alvestav/alvestav-lee-thesis-project-2025/pcb-front-view.png

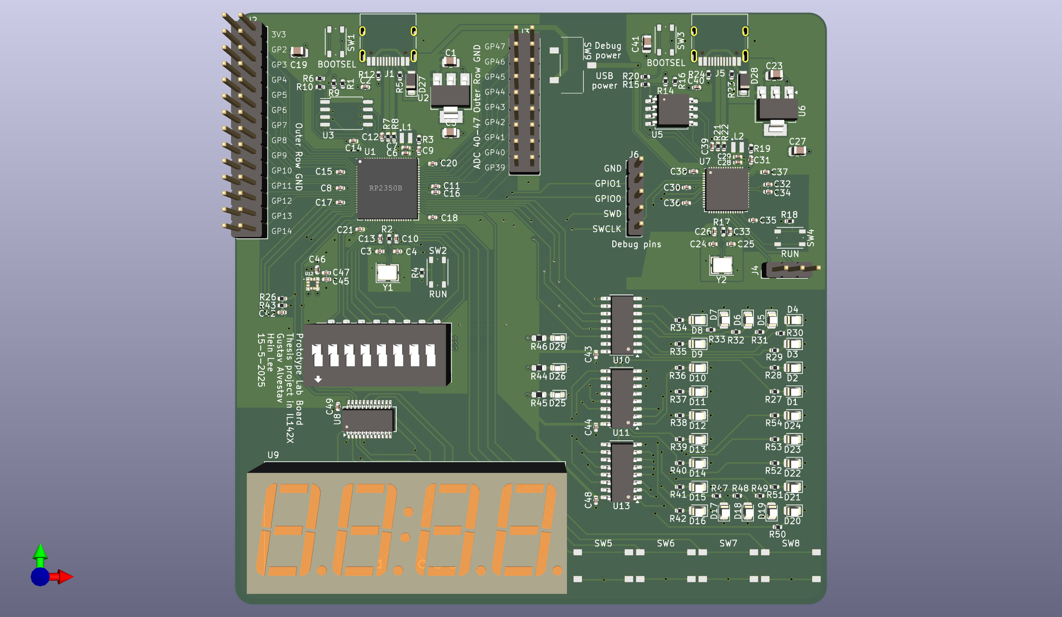
pcb-front-view.png
