alvestav/alvestav-lee-thesis-project-2025/README.md

# alvestav-lee-thesis-project-2025
 This is the GitHub repository for the bachelor thesis project in KTH computer and electronics engineering
