alvestav/alvestav-lee-thesis-project-2025/RP-006442-DD-2-RP2350B Minimal Board Kicad archive/MMA8451QR1.step

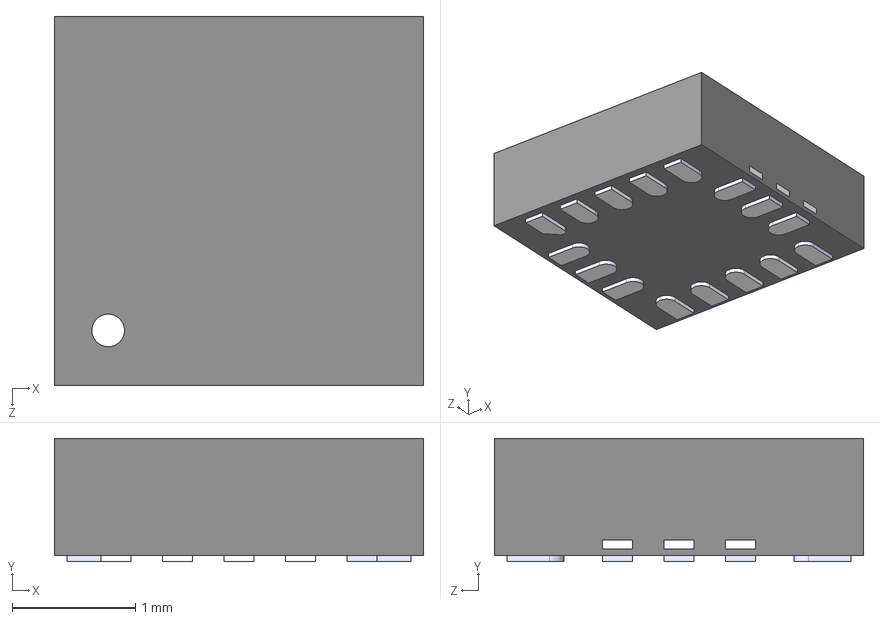
[picture p2: CAD file, 2025-05-16, an earlier design]
RP-006442-DD-2-RP2350B Minimal Board Kicad archive/MMA8451QR1.step
3.00 x 1.00 x 3.00 mm
