alvestav/alvestav-lee-thesis-project-2025/RP-006442-DD-2-RP2350B Minimal Board Kicad archive/W25Q128JVSIQ.step

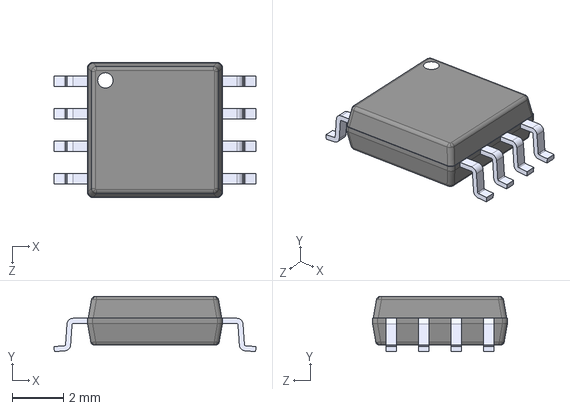
[picture p3: CAD file, 2025-05-16, an earlier design]
RP-006442-DD-2-RP2350B Minimal Board Kicad archive/W25Q128JVSIQ.step
7.90 x 2.16 x 5.28 mm
