alvestav/alvestav-lee-thesis-project-2025/RP-006442-DD-2-RP2350B Minimal Board Kicad archive/LIS2DW12TR.step

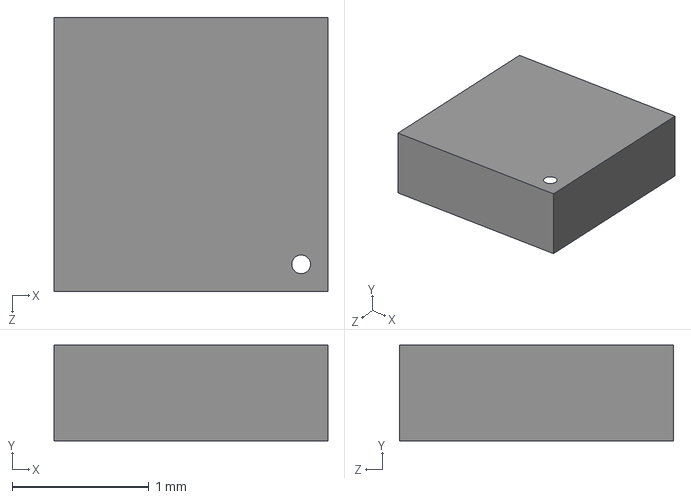
[picture p4: CAD file, 2025-05-13, an earlier design]
RP-006442-DD-2-RP2350B Minimal Board Kicad archive/LIS2DW12TR.step
2.00 x 0.7 x 2.00 mm
