alvestav/alvestav-lee-thesis-project-2025/RP-006442-DD-2-RP2350B Minimal Board Kicad archive/RP2350_QFN60.step

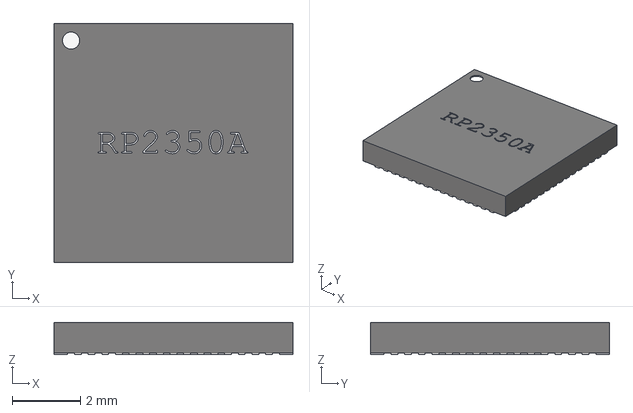
[picture p5: CAD file, 2025-04-09, an earlier design]
RP-006442-DD-2-RP2350B Minimal Board Kicad archive/RP2350_QFN60.step
7.00 x 7.00 x 0.95 mm
