alvestav/alvestav-lee-thesis-project-2025/RP-006442-DD-2-RP2350B Minimal Board Kicad archive/RP2350_QFN80.step

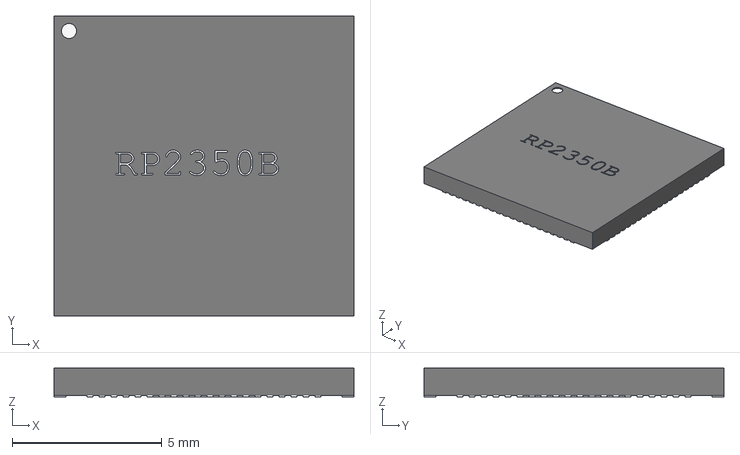
[picture p6: CAD file, 2025-03-20, an earlier design]
RP-006442-DD-2-RP2350B Minimal Board Kicad archive/RP2350_QFN80.step
10.0 x 10.0 x 0.95 mm
