alvestav/alvestav-lee-thesis-project-2025/RP-006442-DD-2-RP2350B Minimal Board Kicad archive/RP2350_80QFN_minimal.kicad_pcb

## KiCad design RP-006442-DD-2-RP2350B Minimal Board Kicad archive/RP2350_80QFN_minimal.kicad_pcb (2025-05-22, an earlier design)

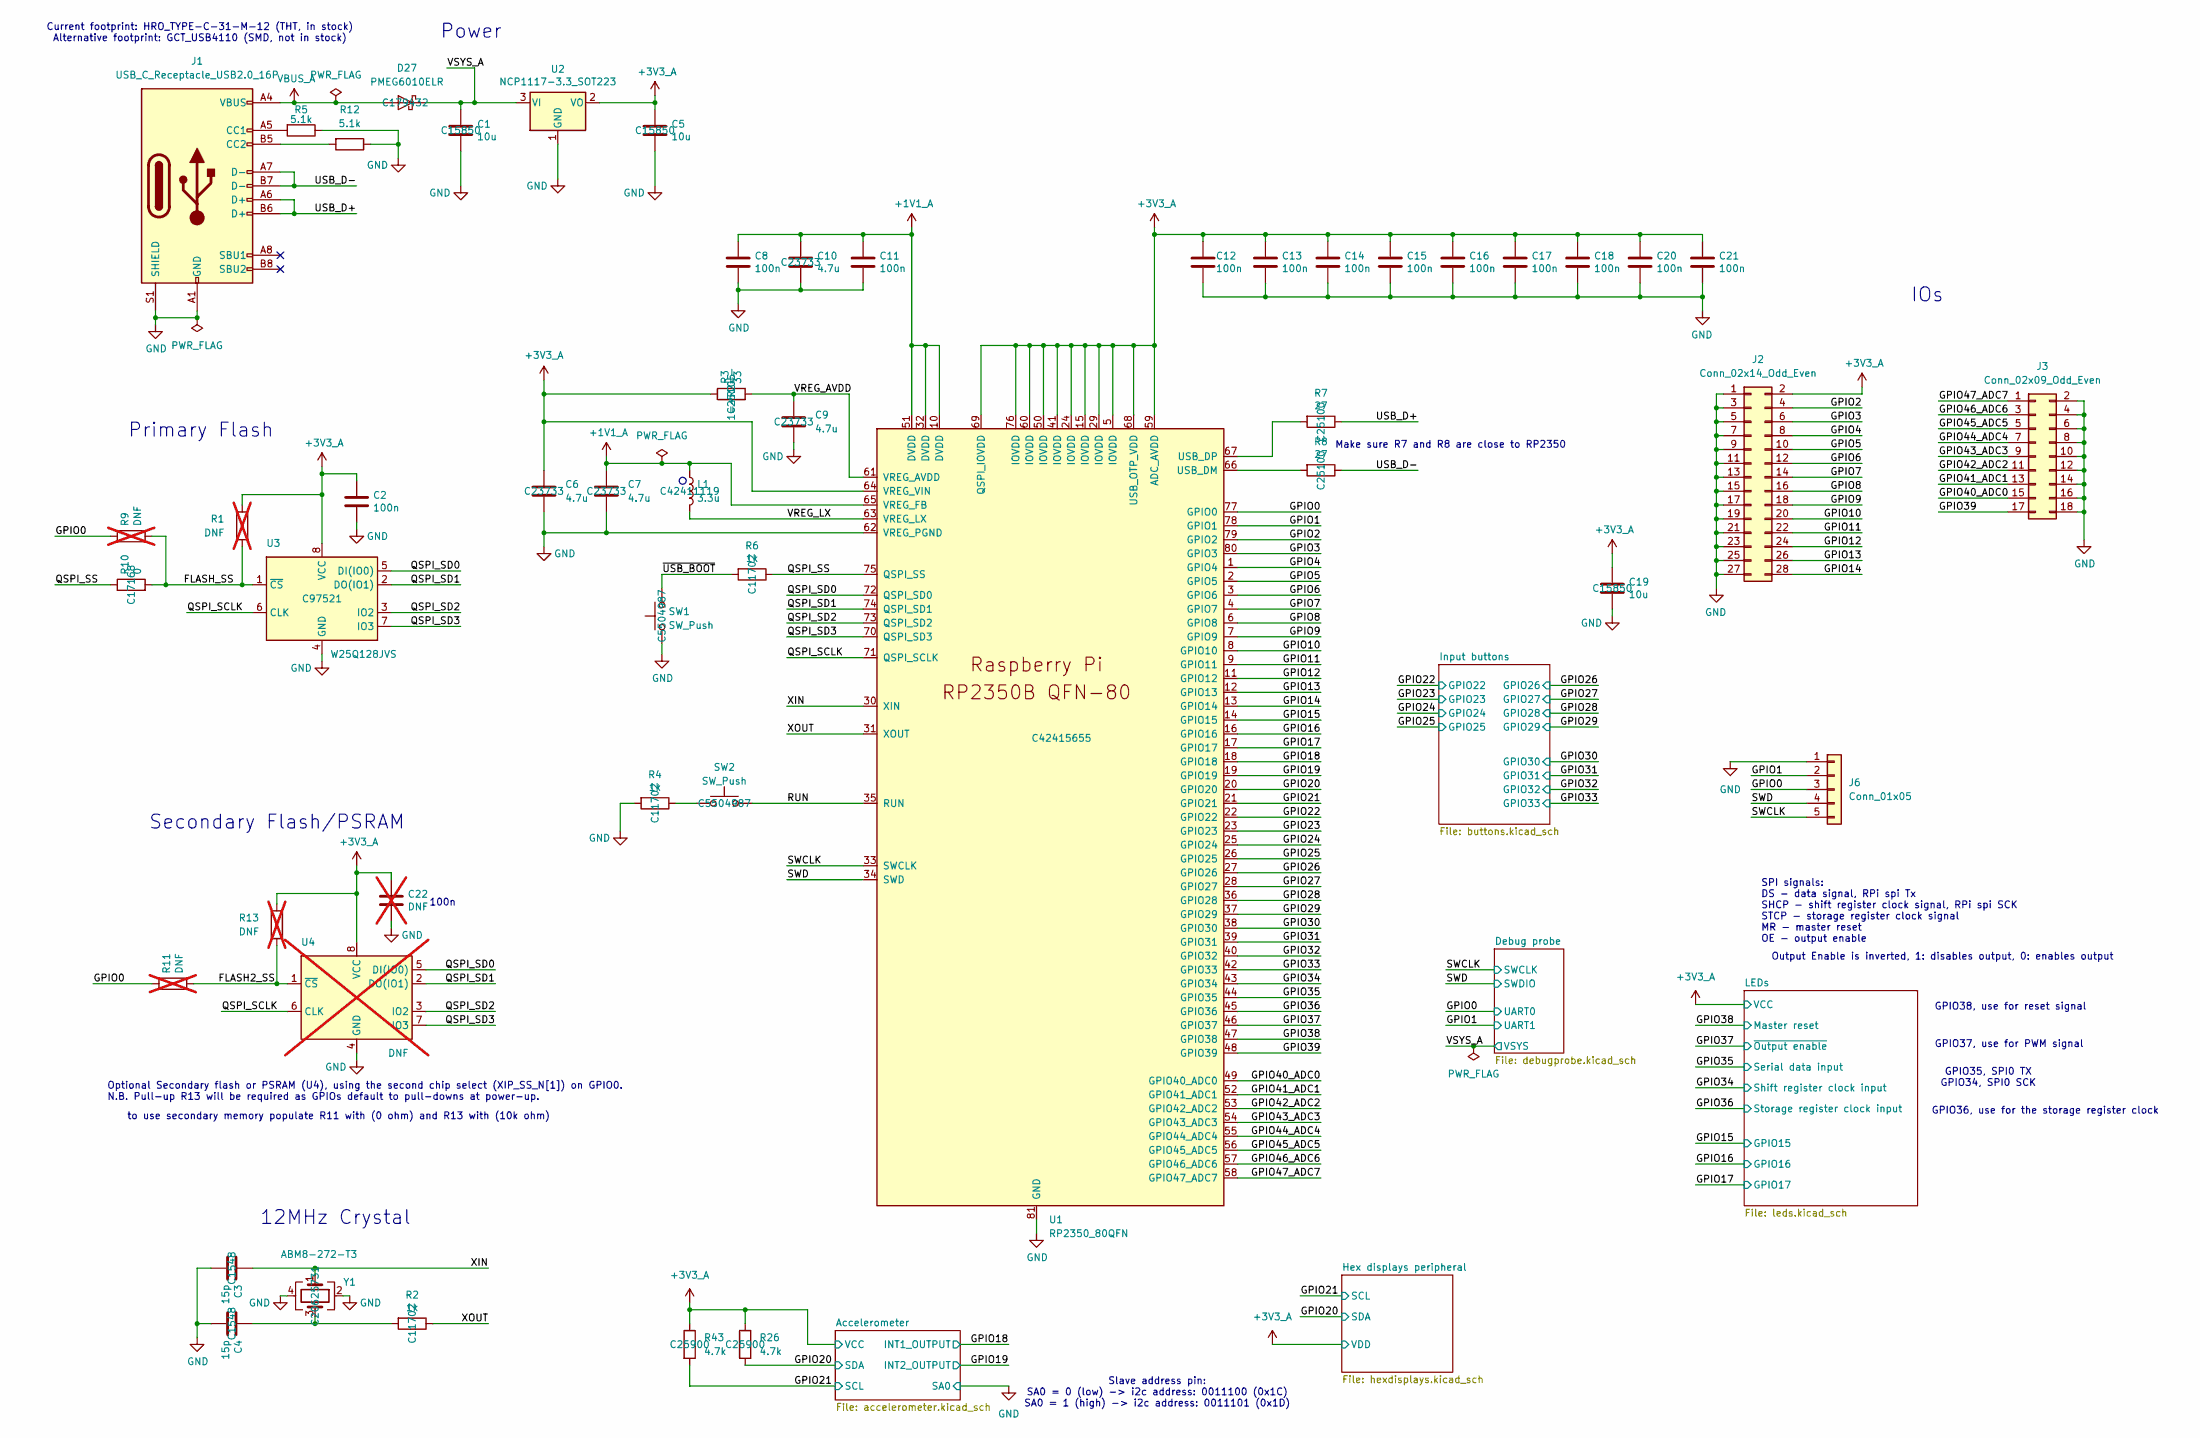
[picture p7: schematic RP2350_80QFN_minimal.kicad_sch, Lab Platform Prototype Thesis Project]

Parts:
C1, C5, C19: 10u; C_0805_2012Metric; LCSC C15850
C2, C8, C11, C12, C13, C14, C15, C16, C17, C18, C20, C21: 100n; C_0402_1005Metric; LCSC C1525
C3, C4: 15p; C_0402_1005Metric; LCSC C1548
C6, C7: 4.7u; C_0402_1005Metric_small_pads; LCSC C23733
C9, C10: 4.7u; C_0402_1005Metric; LCSC C23733
C22: DNF; C_0402_1005Metric; not fitted
D27: PMEG6010ELR; Nexperia_CFP3_SOD-123W; LCSC C179432
J1: USB_C_Receptacle_USB2.0_16P; USB_C_Receptacle_HRO_TYPE-C-31-M-12; LCSC C165948
J2: Conn_02x14_Odd_Even; PinHeader_2x14_P2.54mm_Vertical
J3: Conn_02x09_Odd_Even; PinHeader_2x09_P2.54mm_Vertical
J6: Conn_01x05; PinHeader_1x05_P2.54mm_Vertical
L1: 3.3u; L_pol_2016; LCSC C42411119
R1, R9, R11, R13: DNF; R_0402_1005Metric; not fitted
R2, R4, R6: 1k; R_0402_1005Metric; LCSC C11702
R3: 33; R_0402_1005Metric; LCSC C25105
R5, R12: 5.1k; R_0402_1005Metric; LCSC C25905
R7, R8: 27; R_0402_1005Metric; LCSC C25100
R10: 0; R_0402_1005Metric; LCSC C17168
R26, R43: 4.7k; R_0402_1005Metric; LCSC C25900
SW1, SW2: SW_Push; SW_Push_1P1T_NO_Vertical_Wuerth_434133025816; LCSC C5504987
U1: RP2350_80QFN; RP2350-QFN-80-1EP_10x10_P0.4mm_EP3.4x3.4mm_ThermalVias; LCSC C42415655
U2: NCP1117-3.3_SOT223; SOT-223-3_TabPin2; LCSC C26537
U3: W25Q128JVS; SOIC127P790X216-8N; LCSC C97521
U4: DNF; SOIC127P790X216-8N; not fitted
Y1: ABM8-272-T3; Crystal_SMD_3225-4Pin_3.2x2.5mm; LCSC C20625731

Connections:
+1V1_A: C7.1, C8.1, C10.1, C11.1, L1.1, U1.10 (DVDD), U1.32 (DVDD), U1.51 (DVDD), U1.65 (VREG_FB)
+3V3_A: C2.1, C5.1, C6.1, C12.1, C13.1, C14.1, C15.1, C16.1, C17.1, C18.1, C19.1, C20.1, C21.1, C22.1, J2.2, R1.1, R3.1, R13.1, R26.1, R43.1, U1.5 (IOVDD), U1.15 (IOVDD), U1.24 (IOVDD), U1.29 (IOVDD), U1.41 (IOVDD), U1.50 (IOVDD), U1.59 (ADC_AVDD), U1.60 (IOVDD), U1.64 (VREG_VIN), U1.68 (USB_OTP_VDD), U1.69 (QSPI_IOVDD), U1.76 (IOVDD), U2.2 (VO), U3.8 (VCC), U4.8 (VCC); also elsewhere on the board
/FLASH2_SS: R11.2, R13.2, U4.1 (~CS)
/FLASH_SS: R1.2, R9.2, R10.2, U3.1 (~CS)
/GPIO0: J6.3, R9.1, R11.1, U1.77 (GPIO0); also elsewhere on the board
/GPIO1: J6.2, U1.78 (GPIO1); also elsewhere on the board
/GPIO2: J2.4, U1.79 (GPIO2)
/GPIO3: J2.6, U1.80 (GPIO3)
/GPIO4: J2.8, U1.1 (GPIO4)
/GPIO5: J2.10, U1.2 (GPIO5)
/GPIO6: J2.12, U1.3 (GPIO6)
/GPIO7: J2.14, U1.4 (GPIO7)
/GPIO8: J2.16, U1.6 (GPIO8)
/GPIO9: J2.18, U1.7 (GPIO9)
/GPIO10: J2.20, U1.8 (GPIO10)
/GPIO11: J2.22, U1.9 (GPIO11)
/GPIO12: J2.24, U1.11 (GPIO12)
/GPIO13: J2.26, U1.12 (GPIO13)
/GPIO14: J2.28, U1.13 (GPIO14)
/GPIO15: U1.14 (GPIO15); also elsewhere on the board
/GPIO16: U1.16 (GPIO16); also elsewhere on the board
/GPIO17: U1.17 (GPIO17); also elsewhere on the board
/GPIO18: U1.18 (GPIO18); also elsewhere on the board
/GPIO19: U1.19 (GPIO19); also elsewhere on the board
/GPIO20: R26.2, U1.20 (GPIO20); also elsewhere on the board
/GPIO21: R43.2, U1.21 (GPIO21); also elsewhere on the board
/GPIO22: U1.22 (GPIO22); also elsewhere on the board
/GPIO23: U1.23 (GPIO23); also elsewhere on the board
/GPIO24: U1.25 (GPIO24); also elsewhere on the board
/GPIO25: U1.26 (GPIO25); also elsewhere on the board
/GPIO26: U1.27 (GPIO26); also elsewhere on the board
/GPIO27: U1.28 (GPIO27); also elsewhere on the board
/GPIO28: U1.36 (GPIO28); also elsewhere on the board
/GPIO29: U1.37 (GPIO29); also elsewhere on the board
/GPIO30: U1.38 (GPIO30); also elsewhere on the board
/GPIO31: U1.39 (GPIO31); also elsewhere on the board
/GPIO32: U1.40 (GPIO32); also elsewhere on the board
/GPIO33: U1.42 (GPIO33); also elsewhere on the board
/GPIO34: U1.43 (GPIO34); also elsewhere on the board
/GPIO35: U1.44 (GPIO35); also elsewhere on the board
/GPIO36: U1.45 (GPIO36); also elsewhere on the board
/GPIO37: U1.46 (GPIO37); also elsewhere on the board
/GPIO38: U1.47 (GPIO38); also elsewhere on the board
/GPIO39: J3.17, U1.48 (GPIO39)
/GPIO40_ADC0: J3.15, U1.49 (GPIO40_ADC0)
/GPIO41_ADC1: J3.13, U1.52 (GPIO41_ADC1)
/GPIO42_ADC2: J3.11, U1.53 (GPIO42_ADC2)
/GPIO43_ADC3: J3.9, U1.54 (GPIO43_ADC3)
/GPIO44_ADC4: J3.7, U1.55 (GPIO44_ADC4)
/GPIO45_ADC5: J3.5, U1.56 (GPIO45_ADC5)
/GPIO46_ADC6: J3.3, U1.57 (GPIO46_ADC6)
/GPIO47_ADC7: J3.1, U1.58 (GPIO47_ADC7)
/QSPI_SCLK: U1.71 (QSPI_SCLK), U3.6 (CLK), U4.6 (CLK)
/QSPI_SD0: U1.72 (QSPI_SD0), U3.5 (DI(IO0)), U4.5 (DI(IO0))
/QSPI_SD1: U1.74 (QSPI_SD1), U3.2 (DO(IO1)), U4.2 (DO(IO1))
/QSPI_SD2: U1.73 (QSPI_SD2), U3.3 (IO2), U4.3 (IO2)
/QSPI_SD3: U1.70 (QSPI_SD3), U3.7 (IO3), U4.7 (IO3)
/QSPI_SS: R6.1, R10.1, U1.75 (QSPI_SS)
/RUN: SW2.2, U1.35 (RUN)
/SWCLK: J6.5, U1.33 (SWCLK); also elsewhere on the board
/SWD: J6.4, U1.34 (SWD); also elsewhere on the board
/USB_D+: J1.A6 (D+), J1.B6 (D+), R7.1
/USB_D-: J1.A7 (D-), J1.B7 (D-), R8.1
/VREG_AVDD: C9.1, R3.2, U1.61 (VREG_AVDD)
/VREG_LX: L1.2, U1.63 (VREG_LX)
/VSYS_A: C1.1, D27.1 (K), U2.3 (VI); also elsewhere on the board
/XIN: C3.1, U1.30 (XIN), Y1.1
/XOUT: R2.1, U1.31 (XOUT)
/~USB_BOOT: R6.2, SW1.2
GND: C1.2, C2.2, C3.2, C4.2, C5.2, C6.2, C7.2, C8.2, C9.2, C10.2, C11.2, C12.2, C13.2, C14.2, C15.2, C16.2, C17.2, C18.2, C19.2, C20.2, C21.2, C22.2, J1.A1 (GND), J1.A12 (GND), J1.B1 (GND), J1.B12 (GND), J1.S1 (SHIELD), J2.1, J2.3, J2.5, J2.7, J2.9, J2.11, J2.13, J2.15, J2.17, J2.19, J2.21, J2.23, J2.25, J2.27, J3.2, J3.4, J3.6, J3.8, J3.10, J3.12, J3.14, J3.16, J3.18, J6.1, R4.2, R5.1, R12.1, SW1.1, U1.62 (VREG_PGND), U1.81 (GND), U2.1 (GND), U3.4 (GND), U4.4 (GND), Y1.2, Y1.4; also elsewhere on the board
unnamed: C4.1, R2.2, Y1.3
unnamed: J1.A5 (CC1), R5.2
unnamed: J1.B5 (CC2), R12.2
unnamed: R4.1, SW2.1
unnamed: R8.2, U1.66 (USB_DM)
unnamed: R7.2, U1.67 (USB_DP)
VBUS_A: D27.2 (A), J1.A4 (VBUS), J1.A9 (VBUS), J1.B4 (VBUS), J1.B9 (VBUS)

Notes on the sheet:
Optional Secondary flash or PSRAM (U4), using the second chip select (XIP_SS_N[1]) on GPIO0. N.B. Pull-up R13 will be required as GPIOs default to pull-downs at power-up.
IOs
GPIO36, use for the storage register clock
12MHz Crystal
Current footprint: HRO_TYPE-C-31-M-12 (THT, in stock) Alternative footprint: GCT_USB4110 (SMD, not in stock)
GPIO35, SPI0 TX GPIO34, SPI0 SCK
Slave address pin: SA0 = 0 (low) -> i2c address: 0011100 (0x1C) SA0 = 1 (high) -> i2c address: 0011101 (0x1D)
Primary Flash
100n
Make sure R7 and R8 are close to RP2350
Secondary Flash/PSRAM
SPI signals: DS - data signal, RPi spi Tx SHCP - shift register clock signal, RPi spi SCK STCP - storage register clock signal MR - master reset OE - output enable
Output Enable is inverted, 1: disables output, 0: enables output
GPIO37, use for PWM signal
Power
to use secondary memory populate R11 with (0 ohm) and R13 with (10k ohm)
GPIO38, use for reset signal

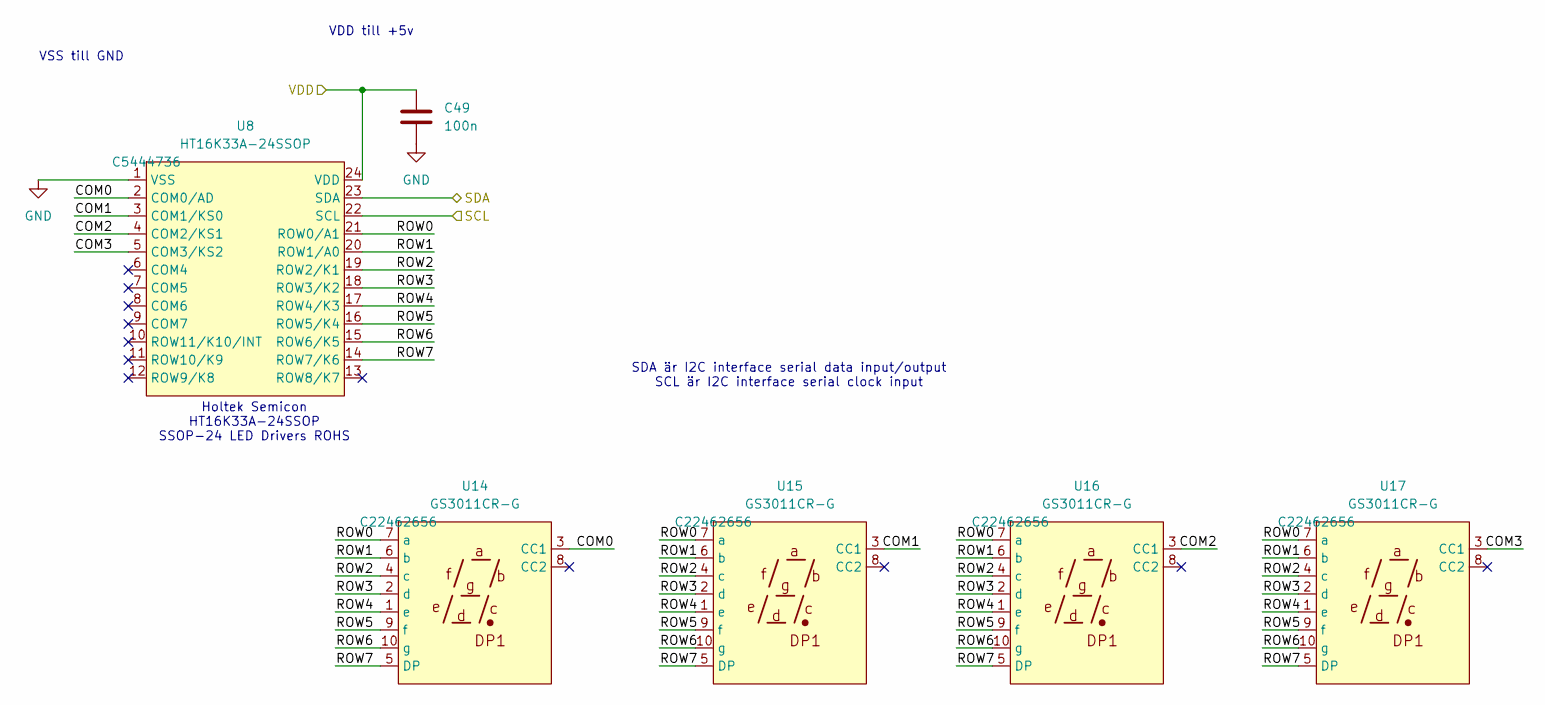
[picture p8: schematic hexdisplays.kicad_sch]

Parts:
C49: 100n; C_0402_1005Metric; LCSC C1525
U8: HT16K33A-24SSOP; SSOP-24_3.9x8.7mm_P0.635mm; LCSC C5444736
U14, U15, U16, U17: GS3011CR-G; LCSC C22462656

Connections:
+3V3_A: C49.1, U8.24 (VDD); also elsewhere on the board
/GPIO20: U8.23 (SDA); also elsewhere on the board
/GPIO21: U8.22 (SCL); also elsewhere on the board
/Hex displays peripheral/COM0: U8.2 (COM0/AD), U14.3 (CC1)
/Hex displays peripheral/COM1: U8.3 (COM1/KS0), U15.3 (CC1)
/Hex displays peripheral/COM2: U8.4 (COM2/KS1), U16.3 (CC1)
/Hex displays peripheral/COM3: U8.5 (COM3/KS2), U17.3 (CC1)
/Hex displays peripheral/ROW0: U8.21 (ROW0/A1), U14.7 (a), U15.7 (a), U16.7 (a), U17.7 (a)
/Hex displays peripheral/ROW1: U8.20 (ROW1/A0), U14.6 (b), U15.6 (b), U16.6 (b), U17.6 (b)
/Hex displays peripheral/ROW2: U8.19 (ROW2/K1), U14.4 (c), U15.4 (c), U16.4 (c), U17.4 (c)
/Hex displays peripheral/ROW3: U8.18 (ROW3/K2), U14.2 (d), U15.2 (d), U16.2 (d), U17.2 (d)
/Hex displays peripheral/ROW4: U8.17 (ROW4/K3), U14.1 (e), U15.1 (e), U16.1 (e), U17.1 (e)
/Hex displays peripheral/ROW5: U8.16 (ROW5/K4), U14.9 (f), U15.9 (f), U16.9 (f), U17.9 (f)
/Hex displays peripheral/ROW6: U8.15 (ROW6/K5), U14.10 (g), U15.10 (g), U16.10 (g), U17.10 (g)
/Hex displays peripheral/ROW7: U8.14 (ROW7/K6), U14.5 (DP), U15.5 (DP), U16.5 (DP), U17.5 (DP)
GND: C49.2, U8.1 (VSS); also elsewhere on the board

Notes on the sheet:
SDA är I2C interface serial data input/output SCL är I2C interface serial clock input
VSS till GND
VDD till +5v
Holtek Semicon HT16K33A-24SSOP SSOP-24 LED Drivers ROHS

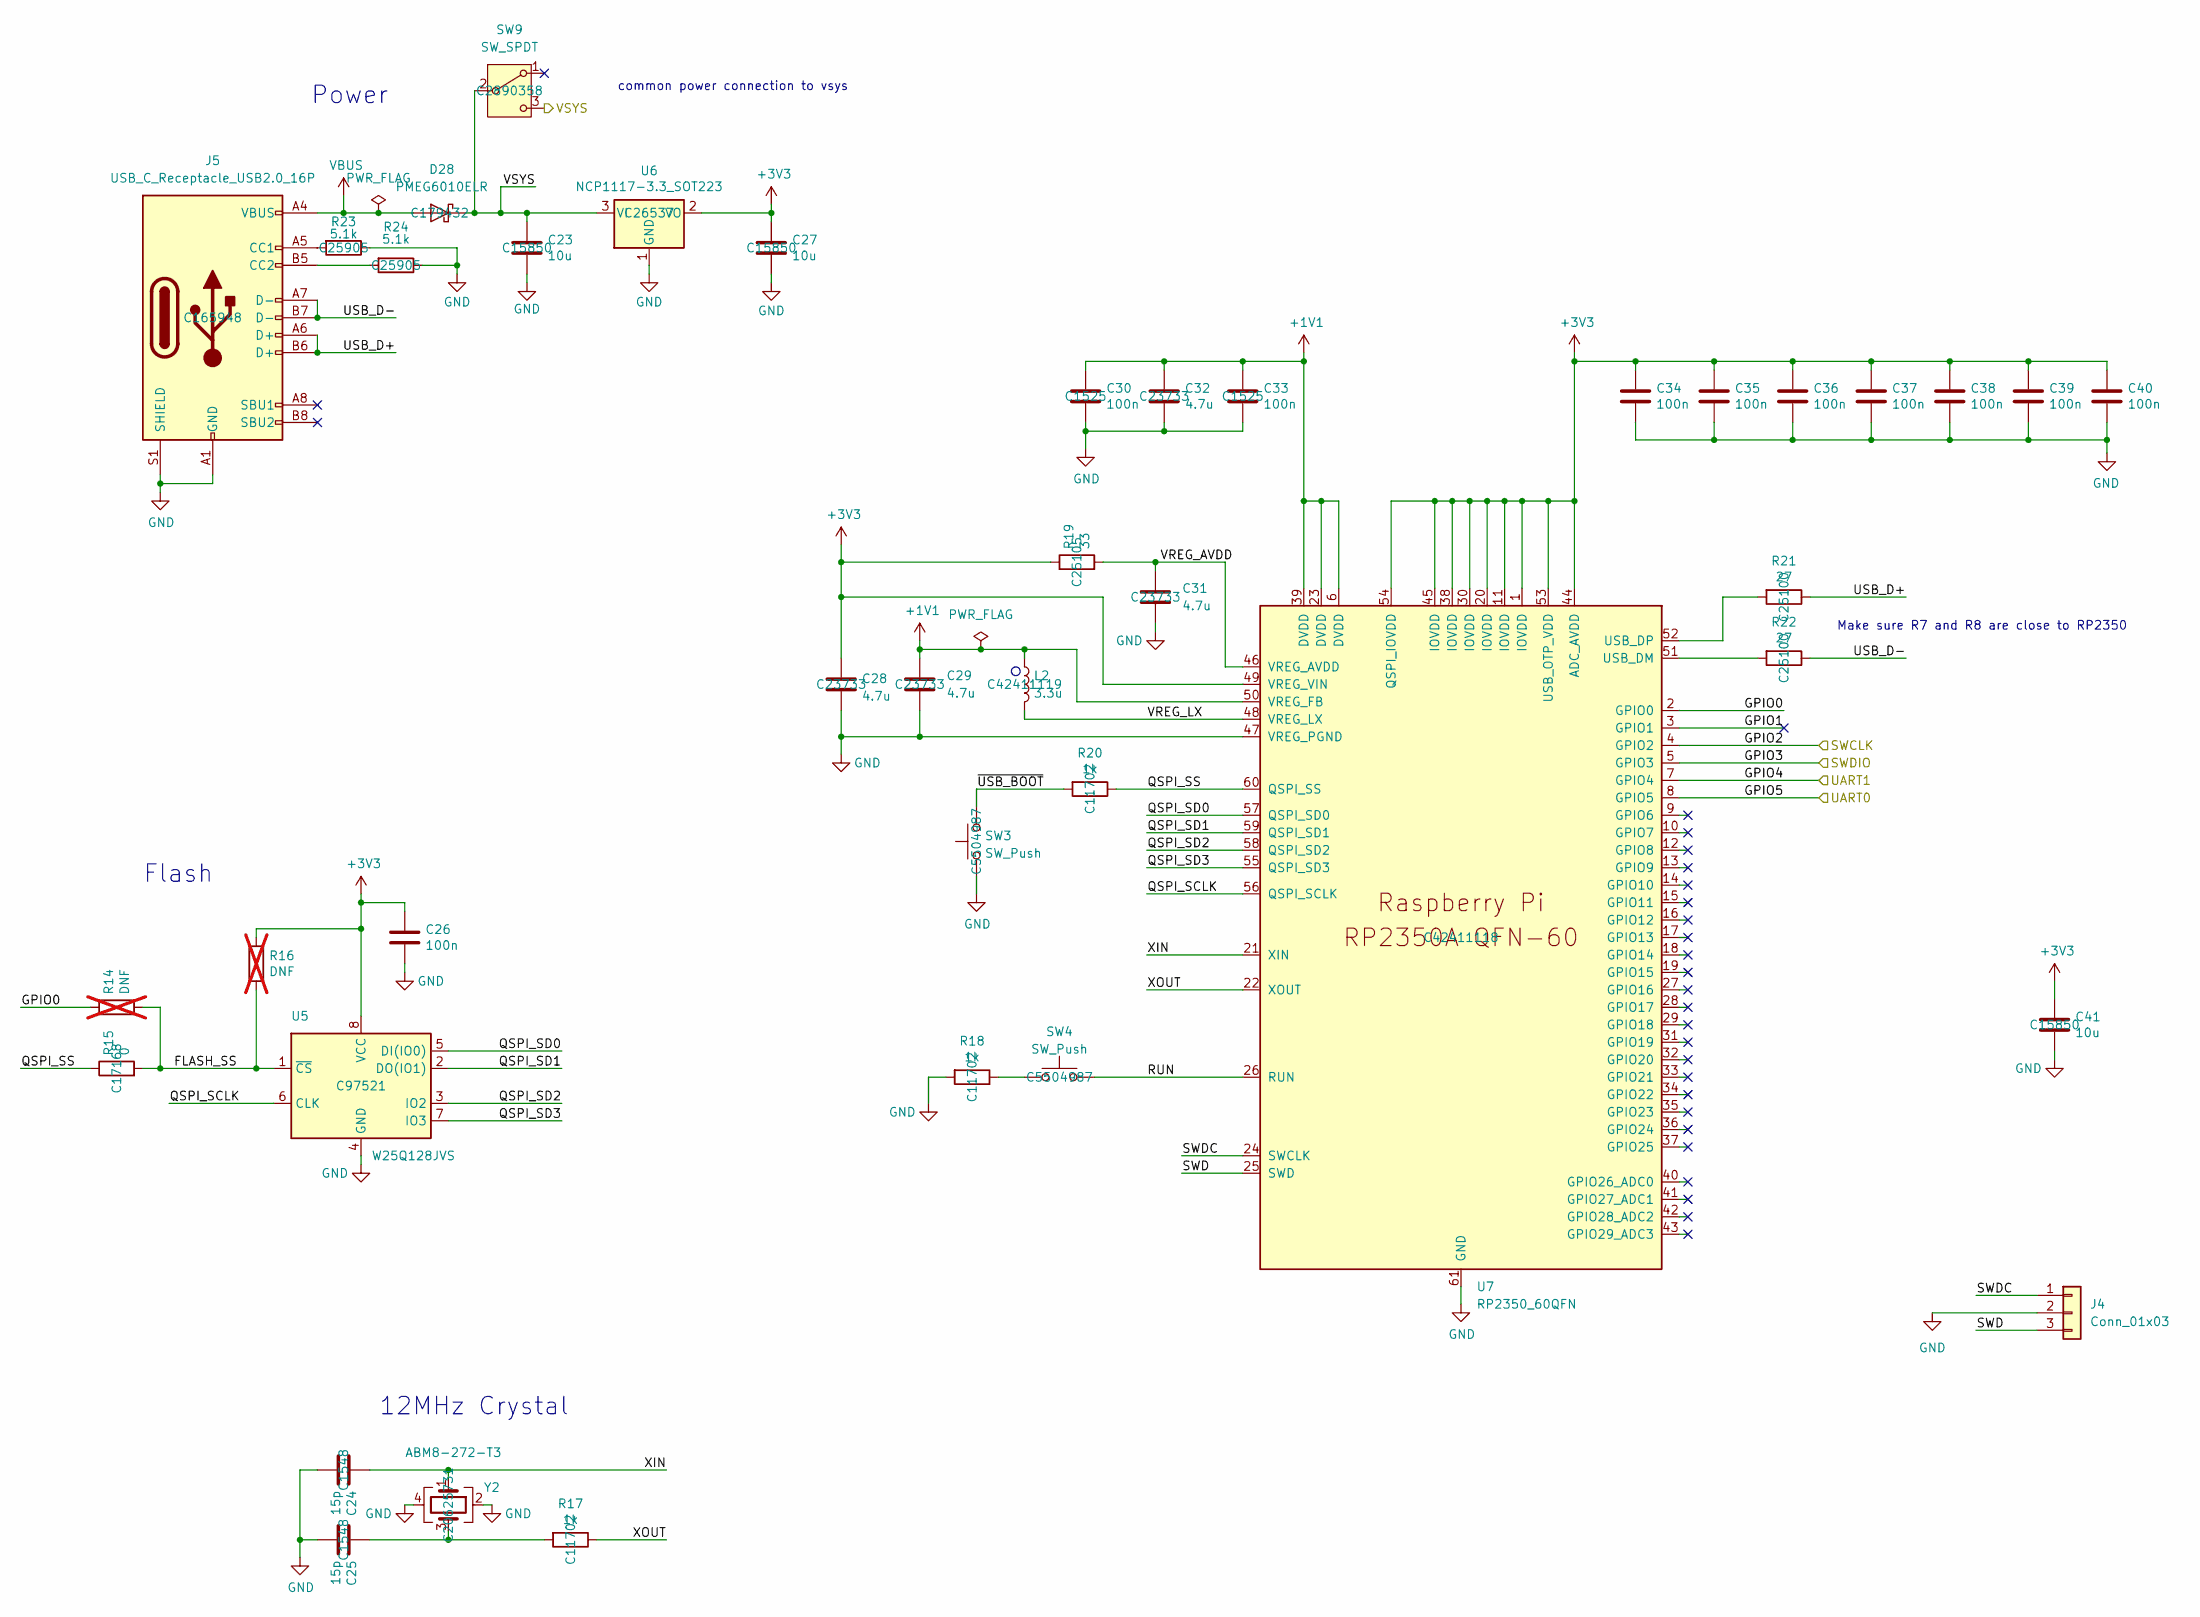
[picture p9: schematic debugprobe.kicad_sch]

Parts:
C23, C27, C41: 10u; C_0805_2012Metric; LCSC C15850
C24, C25: 15p; C_0402_1005Metric; LCSC C1548
C26, C30, C33, C34, C35, C36, C37, C38, C39, C40: 100n; C_0402_1005Metric; LCSC C1525
C28, C29: 4.7u; C_0402_1005Metric_small_pads; LCSC C23733
C31, C32: 4.7u; C_0402_1005Metric; LCSC C23733
D28: PMEG6010ELR; Nexperia_CFP3_SOD-123W; LCSC C179432
J4: Conn_01x03; PinHeader_1x03_P2.54mm_Vertical
J5: USB_C_Receptacle_USB2.0_16P; USB_C_Receptacle_HRO_TYPE-C-31-M-12; LCSC C165948
L2: 3.3u; L_pol_2016; LCSC C42411119
R14, R16: DNF; R_0402_1005Metric; not fitted
R15: 0; R_0402_1005Metric; LCSC C17168
R17, R18, R20: 1k; R_0402_1005Metric; LCSC C11702
R19: 33; R_0402_1005Metric; LCSC C25105
R21, R22: 27; R_0402_1005Metric; LCSC C25100
R23, R24: 5.1k; R_0402_1005Metric; LCSC C25905
SW3, SW4: SW_Push; SW_Push_1P1T_NO_Vertical_Wuerth_434133025816; LCSC C5504987
SW9: SW_SPDT; SW_SPDT_G-Switch_MK-12C03-G015; LCSC C2890358
U5: W25Q128JVS; SOIC127P790X216-8N; LCSC C97521
U6: NCP1117-3.3_SOT223; SOT-223-3_TabPin2; LCSC C26537
U7: RP2350_60QFN; RP2350-QFN-60-1EP_7x7_P0.4mm_EP3.4x3.4mm_ThermalVias; LCSC C42411118
Y2: ABM8-272-T3; Crystal_SMD_3225-4Pin_3.2x2.5mm; LCSC C20625731

Connections:
+1V1: C29.1, C30.1, C32.1, C33.1, L2.1, U7.6 (DVDD), U7.23 (DVDD), U7.39 (DVDD), U7.50 (VREG_FB)
+3V3: C26.1, C27.1, C28.1, C34.1, C35.1, C36.1, C37.1, C38.1, C39.1, C40.1, C41.1, R16.1, R19.1, U5.8 (VCC), U6.2 (VO), U7.1 (IOVDD), U7.11 (IOVDD), U7.20 (IOVDD), U7.30 (IOVDD), U7.38 (IOVDD), U7.44 (ADC_AVDD), U7.45 (IOVDD), U7.49 (VREG_VIN), U7.53 (USB_OTP_VDD), U7.54 (QSPI_IOVDD)
/Debug probe/FLASH_SS: R14.2, R15.2, R16.2, U5.1 (~CS)
/Debug probe/GPIO0: R14.1, U7.2 (GPIO0)
/Debug probe/GPIO1: U7.3 (GPIO1)
/Debug probe/QSPI_SCLK: U5.6 (CLK), U7.56 (QSPI_SCLK)
/Debug probe/QSPI_SD0: U5.5 (DI(IO0)), U7.57 (QSPI_SD0)
/Debug probe/QSPI_SD1: U5.2 (DO(IO1)), U7.59 (QSPI_SD1)
/Debug probe/QSPI_SD2: U5.3 (IO2), U7.58 (QSPI_SD2)
/Debug probe/QSPI_SD3: U5.7 (IO3), U7.55 (QSPI_SD3)
/Debug probe/QSPI_SS: R15.1, R20.1, U7.60 (QSPI_SS)
/Debug probe/RUN: SW4.2, U7.26 (RUN)
/Debug probe/SWD: J4.3, U7.25 (SWD)
/Debug probe/SWDC: J4.1, U7.24 (SWCLK)
/Debug probe/USB_D+: J5.A6 (D+), J5.B6 (D+), R21.1
/Debug probe/USB_D-: J5.A7 (D-), J5.B7 (D-), R22.1
/Debug probe/VREG_AVDD: C31.1, R19.2, U7.46 (VREG_AVDD)
/Debug probe/VREG_LX: L2.2, U7.48 (VREG_LX)
/Debug probe/XIN: C24.1, U7.21 (XIN), Y2.1
/Debug probe/XOUT: R17.1, U7.22 (XOUT)
/Debug probe/~USB_BOOT: R20.2, SW3.2
/GPIO0: U7.8 (GPIO5); also elsewhere on the board
/GPIO1: U7.7 (GPIO4); also elsewhere on the board
/SWCLK: U7.4 (GPIO2); also elsewhere on the board
/SWD: U7.5 (GPIO3); also elsewhere on the board
/VSYS_A: C23.1, D28.1 (K), SW9.2 (B), SW9.3 (C), U6.3 (VI); also elsewhere on the board
GND: C23.2, C24.2, C25.2, C26.2, C27.2, C28.2, C29.2, C30.2, C31.2, C32.2, C33.2, C34.2, C35.2, C36.2, C37.2, C38.2, C39.2, C40.2, C41.2, J4.2, J5.A1 (GND), J5.A12 (GND), J5.B1 (GND), J5.B12 (GND), J5.S1 (SHIELD), R18.2, R23.1, R24.1, SW3.1, U5.4 (GND), U6.1 (GND), U7.47 (VREG_PGND), U7.61 (GND), Y2.2, Y2.4; also elsewhere on the board
unnamed: C25.1, R17.2, Y2.3
unnamed: J5.A5 (CC1), R23.2
unnamed: J5.B5 (CC2), R24.2
unnamed: R18.1, SW4.1
unnamed: R22.2, U7.51 (USB_DM)
unnamed: R21.2, U7.52 (USB_DP)
VBUS: D28.2 (A), J5.A4 (VBUS), J5.A9 (VBUS), J5.B4 (VBUS), J5.B9 (VBUS)

Notes on the sheet:
Power
Flash
common power connection to vsys
Make sure R7 and R8 are close to RP2350
12MHz Crystal

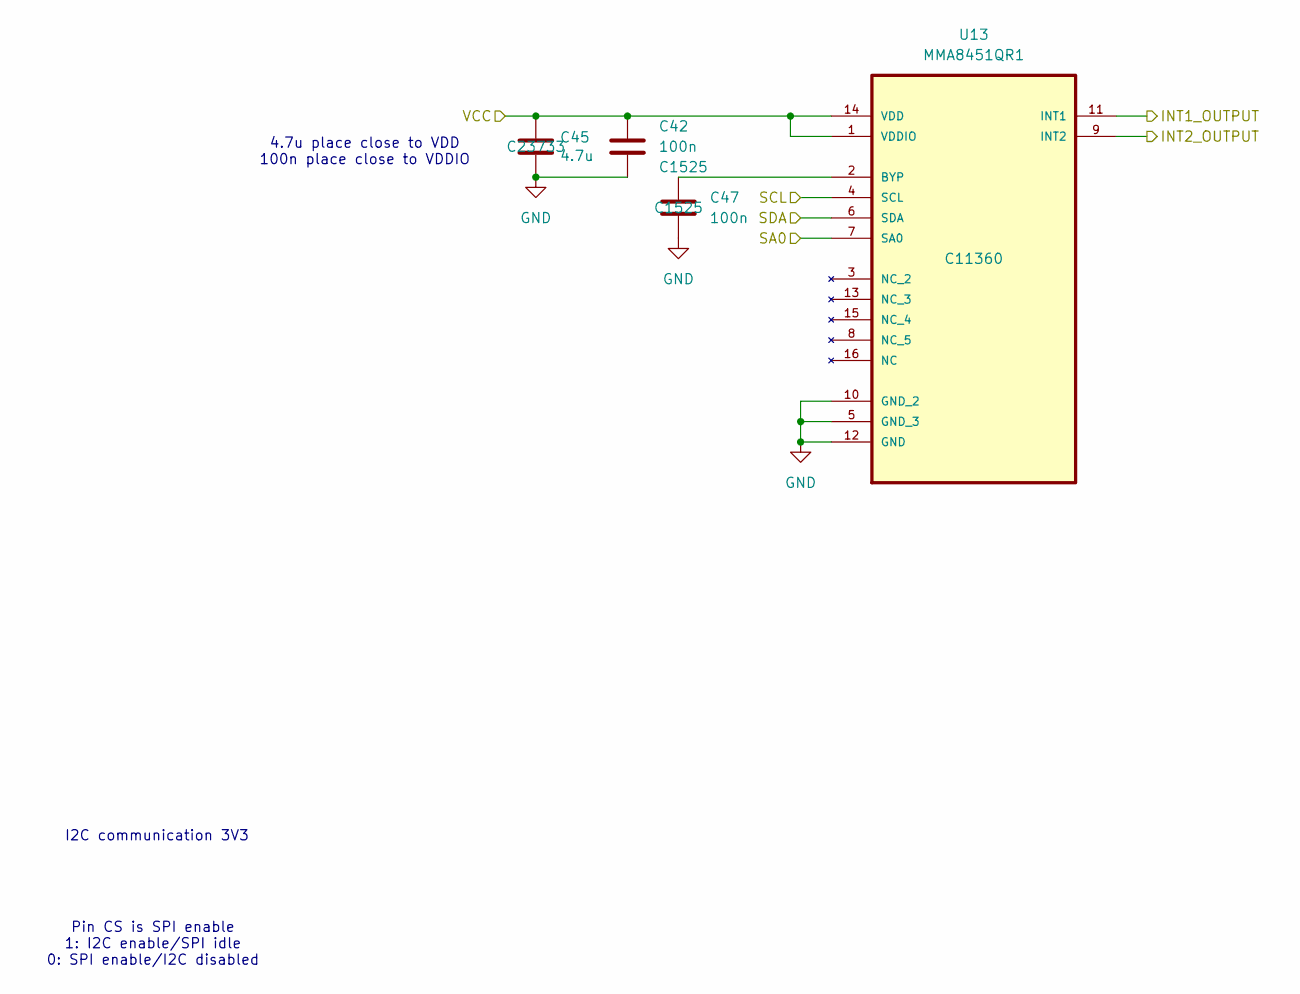
[picture p10: schematic accelerometer.kicad_sch]

Parts:
C42, C47: 100n; C_0402_1005Metric; LCSC C1525
C45: 4.7u; C_0402_1005Metric; LCSC C23733
U13: MMA8451QR1; QFN50P300X300X100-16N; MPN MMA8451QR1; LCSC C11360

Connections:
+3V3_A: C42.1, C45.1, U13.1 (VDDIO), U13.14 (VDD); also elsewhere on the board
/GPIO18: U13.11 (INT1); also elsewhere on the board
/GPIO19: U13.9 (INT2); also elsewhere on the board
/GPIO20: U13.6 (SDA); also elsewhere on the board
/GPIO21: U13.4 (SCL); also elsewhere on the board
GND: C42.2, C45.2, C47.2, U13.5 (GND_3), U13.7 (SA0), U13.10 (GND_2), U13.12 (GND); also elsewhere on the board
unnamed: C47.1, U13.2 (BYP)

Notes on the sheet:
4.7u place close to VDD 100n place close to VDDIO
Pin CS is SPI enable 1: I2C enable/SPI idle 0: SPI enable/I2C disabled
I2C communication 3V3

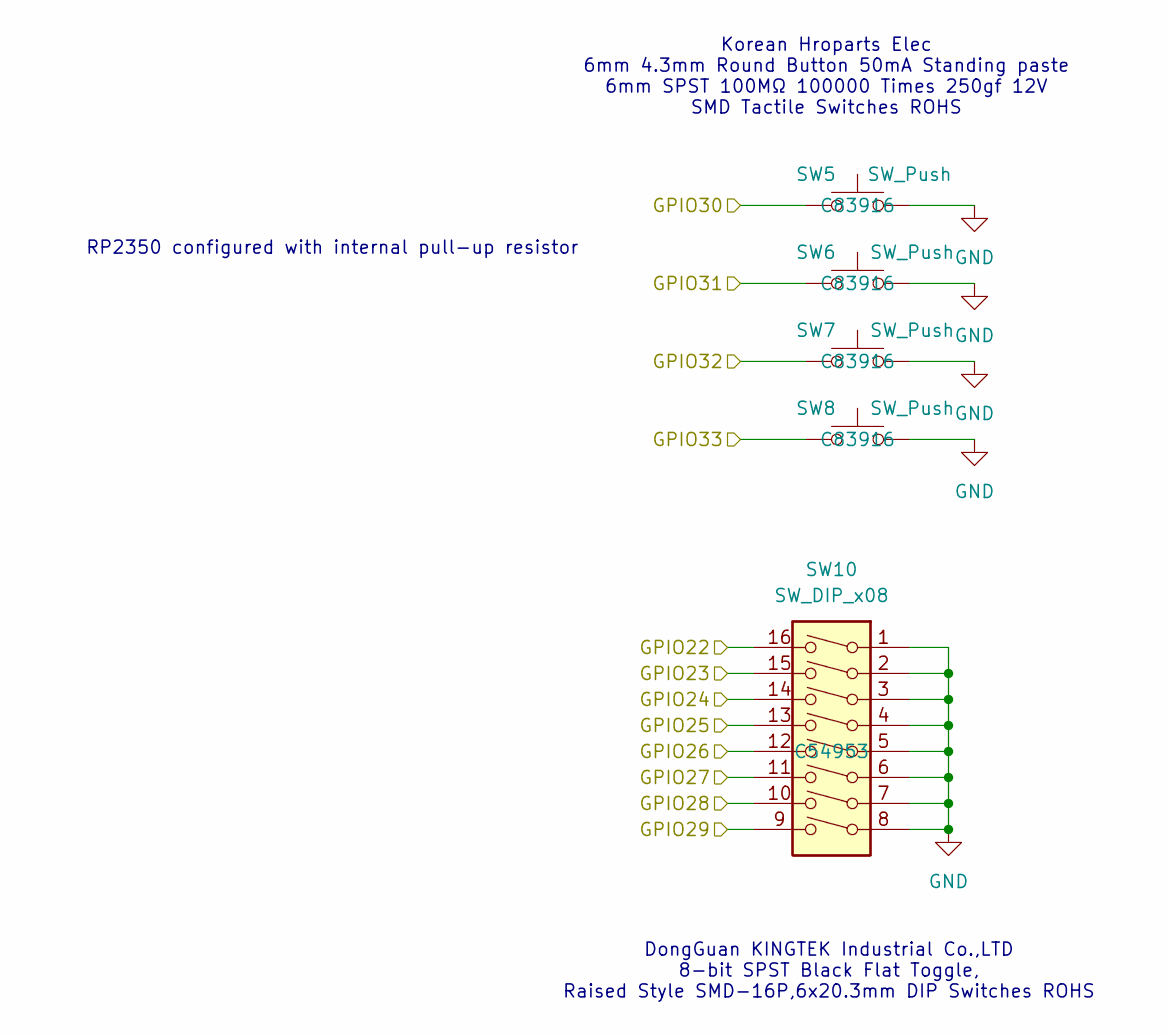
[picture p11: schematic buttons.kicad_sch]

Parts:
SW5, SW6, SW7, SW8: SW_Push; SW_Push_K2-1102SP-A4SC-04; LCSC C83916
SW10: SW_DIP_x08; SW_DIP_SPSTx08_Slide_9.78x22.5mm_W8.61mm_P2.54mm; LCSC C54953

Connections:
/GPIO22: SW10.16; also elsewhere on the board
/GPIO23: SW10.15; also elsewhere on the board
/GPIO24: SW10.14; also elsewhere on the board
/GPIO25: SW10.13; also elsewhere on the board
/GPIO26: SW10.12; also elsewhere on the board
/GPIO27: SW10.11; also elsewhere on the board
/GPIO28: SW10.10; also elsewhere on the board
/GPIO29: SW10.9; also elsewhere on the board
/GPIO30: SW5.1; also elsewhere on the board
/GPIO31: SW6.1; also elsewhere on the board
/GPIO32: SW7.1; also elsewhere on the board
/GPIO33: SW8.1; also elsewhere on the board
GND: SW5.2, SW6.2, SW7.2, SW8.2, SW10.1, SW10.2, SW10.3, SW10.4, SW10.5, SW10.6, SW10.7, SW10.8; also elsewhere on the board

Notes on the sheet:
DongGuan KINGTEK Industrial Co.,LTD 8-bit SPST Black Flat Toggle, Raised Style SMD-16P,6x20.3mm DIP Switches ROHS
Korean Hroparts Elec 6mm 4.3mm Round Button 50mA Standing paste 6mm SPST 100MΩ 100000 Times 250gf 12V SMD Tactile Switches ROHS
RP2350 configured with internal pull-up resistor

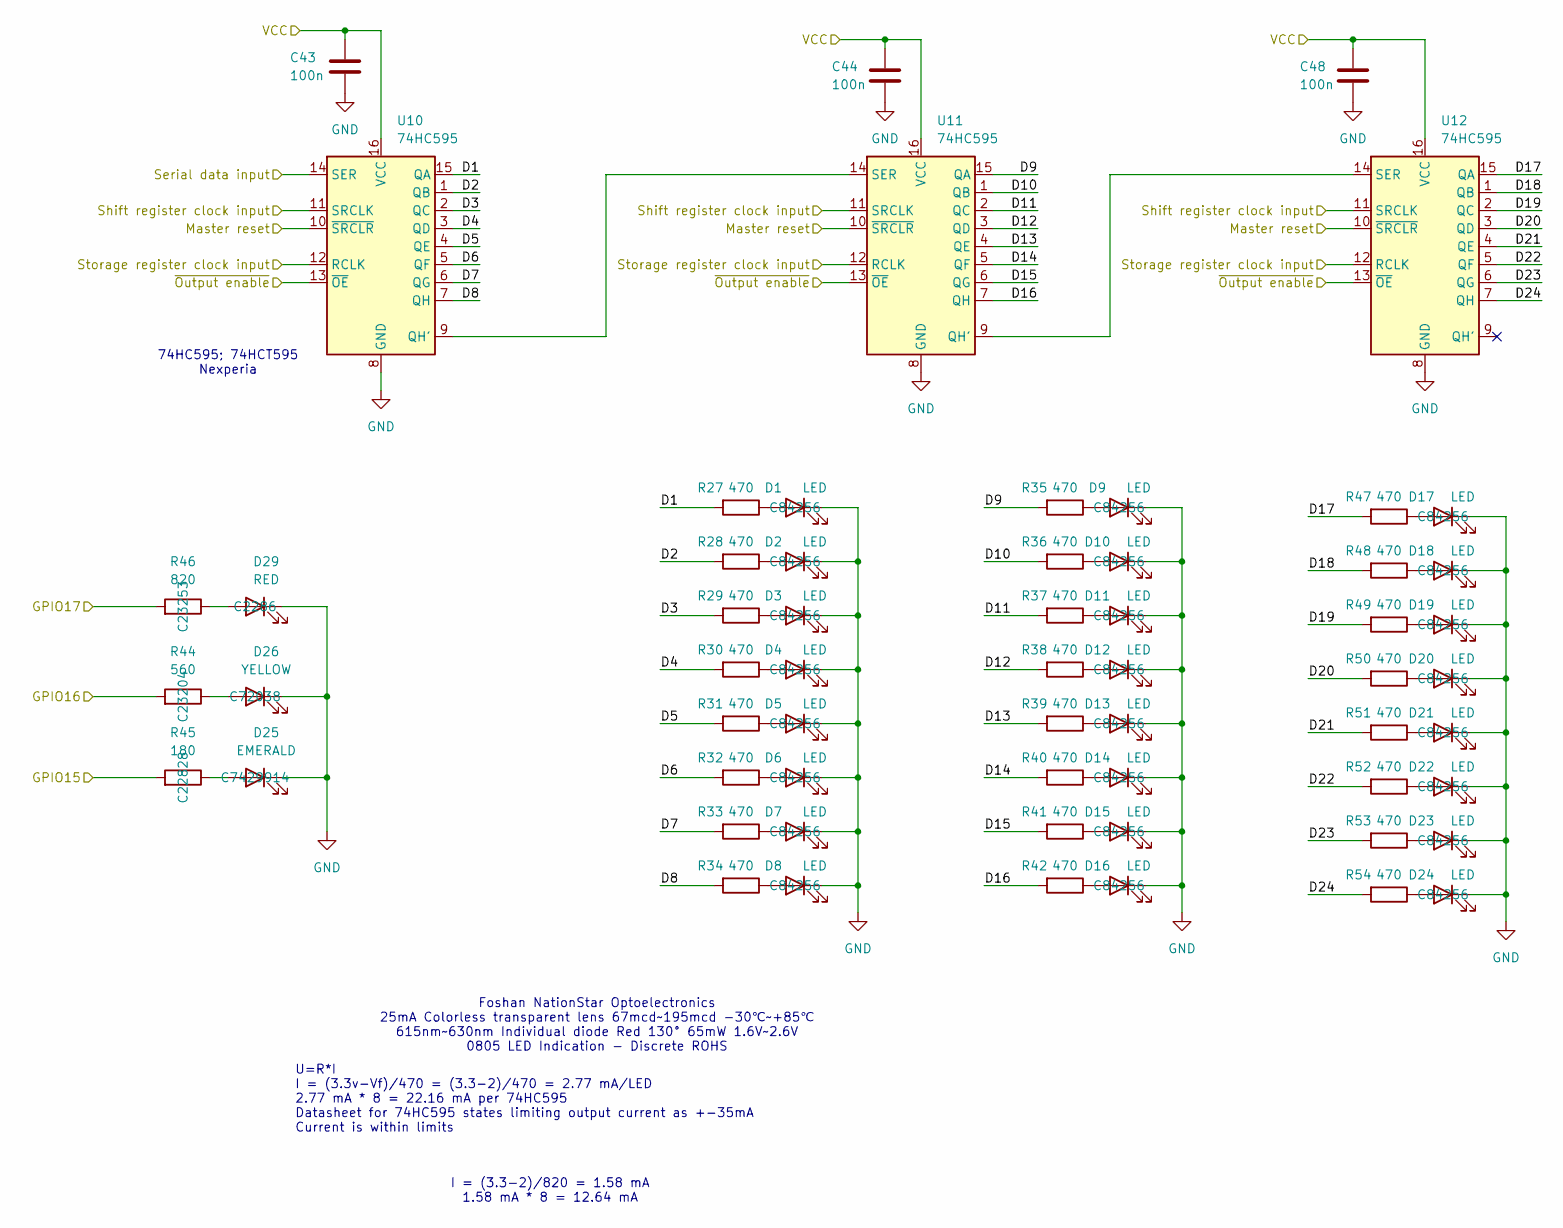
[picture p12: schematic leds.kicad_sch]

Parts:
C43, C44, C48: 100n; C_0402_1005Metric; LCSC C1525
D1, D2, D3, D4, D5, D6, D7, D8, D9, D10, D11, D12, D13, D14, D15, D16, D17, D18, D19, D20, D21, D22, D23, D24: LED; LED_0805_2012Metric; LCSC C84256
D25: EMERALD; LED_0603_1608Metric; LCSC C7429914
D26: YELLOW; LED_0603_1608Metric; LCSC C72038
D29: RED; LED_0603_1608Metric; LCSC C2286
R27, R28, R29, R30, R31, R32, R33, R34, R35, R36, R37, R38, R39, R40, R41, R42, R47, R48, R49, R50, R51, R52, R53, R54: 470; R_0402_1005Metric; LCSC C25117
R44: 560; R_0603_1608Metric; LCSC C23204
R45: 180; R_0603_1608Metric; LCSC C22828
R46: 820; R_0603_1608Metric; LCSC C23253
U10, U11, U12: 74HC595; SOIC-16_3.9x9.9mm_P1.27mm; LCSC C5947

Connections:
+3V3_A: C43.1, C44.1, C48.1, U10.16 (VCC), U11.16 (VCC), U12.16 (VCC); also elsewhere on the board
/GPIO15: R45.2; also elsewhere on the board
/GPIO16: R44.2; also elsewhere on the board
/GPIO17: R46.2; also elsewhere on the board
/GPIO34: U10.11 (SRCLK), U11.11 (SRCLK), U12.11 (SRCLK); also elsewhere on the board
/GPIO35: U10.14 (SER); also elsewhere on the board
/GPIO36: U10.12 (RCLK), U11.12 (RCLK), U12.12 (RCLK); also elsewhere on the board
/GPIO37: U10.13 (~OE), U11.13 (~OE), U12.13 (~OE); also elsewhere on the board
/GPIO38: U10.10 (~SRCLR), U11.10 (~SRCLR), U12.10 (~SRCLR); also elsewhere on the board
/LEDs/D1: R27.2, U10.15 (QA)
/LEDs/D2: R28.2, U10.1 (QB)
/LEDs/D3: R29.2, U10.2 (QC)
/LEDs/D4: R30.2, U10.3 (QD)
/LEDs/D5: R31.2, U10.4 (QE)
/LEDs/D6: R32.2, U10.5 (QF)
/LEDs/D7: R33.2, U10.6 (QG)
/LEDs/D8: R34.2, U10.7 (QH)
/LEDs/D9: R35.2, U11.15 (QA)
/LEDs/D10: R36.2, U11.1 (QB)
/LEDs/D11: R37.2, U11.2 (QC)
/LEDs/D12: R38.2, U11.3 (QD)
/LEDs/D13: R39.2, U11.4 (QE)
/LEDs/D14: R40.2, U11.5 (QF)
/LEDs/D15: R41.2, U11.6 (QG)
/LEDs/D16: R42.2, U11.7 (QH)
/LEDs/D17: R47.2, U12.15 (QA)
/LEDs/D18: R48.2, U12.1 (QB)
/LEDs/D19: R49.2, U12.2 (QC)
/LEDs/D20: R50.2, U12.3 (QD)
/LEDs/D21: R51.2, U12.4 (QE)
/LEDs/D22: R52.2, U12.5 (QF)
/LEDs/D23: R53.2, U12.6 (QG)
/LEDs/D24: R54.2, U12.7 (QH)
GND: C43.2, C44.2, C48.2, D1.1 (K), D2.1 (K), D3.1 (K), D4.1 (K), D5.1 (K), D6.1 (K), D7.1 (K), D8.1 (K), D9.1 (K), D10.1 (K), D11.1 (K), D12.1 (K), D13.1 (K), D14.1 (K), D15.1 (K), D16.1 (K), D17.1 (K), D18.1 (K), D19.1 (K), D20.1 (K), D21.1 (K), D22.1 (K), D23.1 (K), D24.1 (K), D25.1 (K), D26.1 (K), D29.1 (K), U10.8 (GND), U11.8 (GND), U12.8 (GND); also elsewhere on the board
unnamed: D1.2 (A), R27.1
unnamed: D2.2 (A), R28.1
unnamed: D3.2 (A), R29.1
unnamed: D4.2 (A), R30.1
unnamed: D5.2 (A), R31.1
unnamed: D6.2 (A), R32.1
unnamed: D7.2 (A), R33.1
unnamed: D8.2 (A), R34.1
unnamed: D9.2 (A), R35.1
unnamed: D10.2 (A), R36.1
unnamed: D11.2 (A), R37.1
unnamed: D12.2 (A), R38.1
unnamed: D13.2 (A), R39.1
unnamed: D14.2 (A), R40.1
unnamed: D15.2 (A), R41.1
unnamed: D16.2 (A), R42.1
unnamed: D17.2 (A), R47.1
unnamed: D18.2 (A), R48.1
unnamed: D19.2 (A), R49.1
unnamed: D20.2 (A), R50.1
unnamed: D21.2 (A), R51.1
unnamed: D22.2 (A), R52.1
unnamed: D23.2 (A), R53.1
unnamed: D24.2 (A), R54.1
unnamed: D25.2 (A), R45.1
unnamed: D26.2 (A), R44.1
unnamed: D29.2 (A), R46.1
unnamed: U10.9 (QH'), U11.14 (SER)
unnamed: U11.9 (QH'), U12.14 (SER)

Notes on the sheet:
74HC595; 74HCT595 Nexperia
I = (3.3-2)/820 = 1.58 mA 1.58 mA * 8 = 12.64 mA
Foshan NationStar Optoelectronics 25mA Colorless transparent lens 67mcd~195mcd -30℃~+85℃ 615nm~630nm Individual diode Red 130° 65mW 1.6V~2.6V 0805 LED Indication - Discrete ROHS
U=R*I I = (3.3v-Vf)/470 = (3.3-2)/470 = 2.77 mA/LED 2.77 mA * 8 = 22.16 mA per 74HC595 Datasheet for 74HC595 states limiting output current as +-35mA Current is within limits
