alvestav/alvestav-lee-thesis-project-2025/RP-006442-DD-2-RP2350B Minimal Board Kicad archive/RP2350_80QFN_minimal.kicad_pcb

## KiCad design RP-006442-DD-2-RP2350B Minimal Board Kicad archive/RP2350_80QFN_minimal.kicad_pcb (continued)

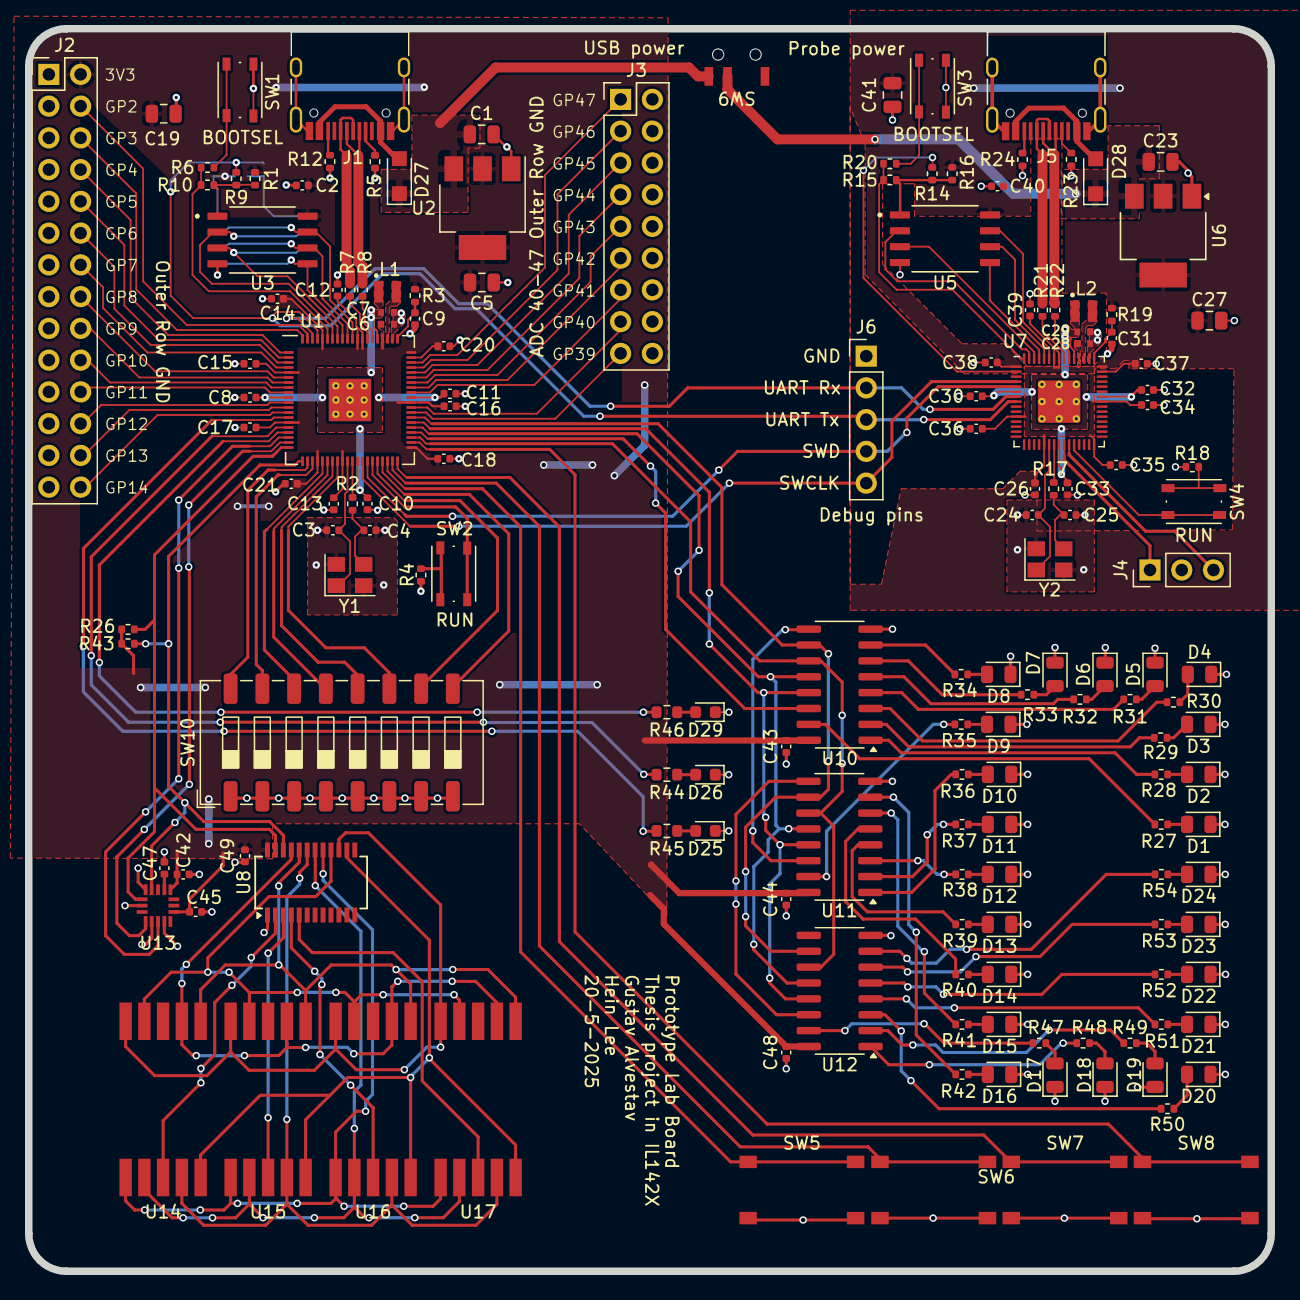
[picture p13: board RP2350_80QFN_minimal.kicad_pcb from above]

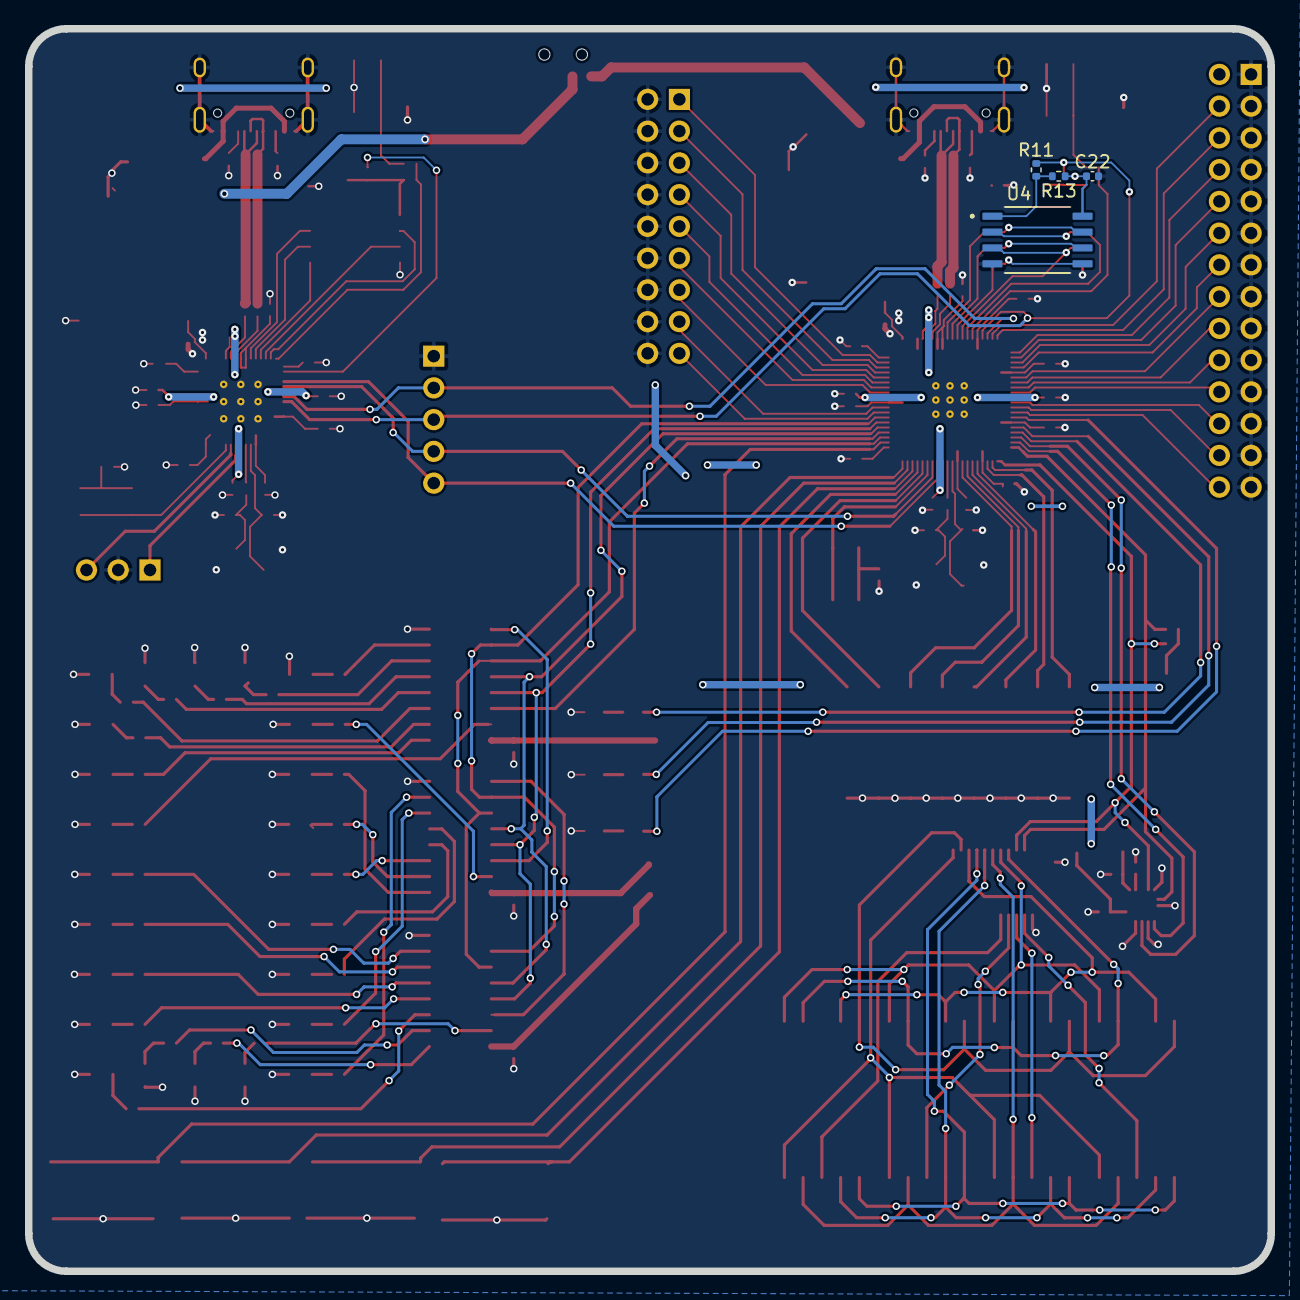
[picture p14: board RP2350_80QFN_minimal.kicad_pcb from below]

Board: 2 copper layers, 99.4 x 99.4 mm, 166 parts (4 on the bottom side), 170 nets.
