alvestav/alvestav-lee-thesis-project-2025/(commit log)

2025-03-21 test commit
    [RP2350_80QFN_minimal.kicad_sch]
2025-03-21 Removed schematic symbol
    removed micro usb symbol from schematic
    [RP2350_80QFN_minimal.kicad_sch]
2025-03-24 Added schematic page, symbol library
    added schematic page and RP2040 symbol library from RP2040 minimal pcb project.
    [RP2350_80QFN_minimal.kicad_sch, untitled.kicad_sch]
2025-03-24 added usb-c to pcb editor
    [RP2350_80QFN_minimal.kicad_pcb, RP2350_80QFN_minimal.kicad_sch, untitled.kicad_sch]
2025-03-24 added 5.1k ohm resistors to usb-c CC1 and CC2
    [RP2350_80QFN_minimal.kicad_sch]
2025-03-25 moved usb type-c on pcb
    removed micro usb footprint
    [RP2350_80QFN_minimal.kicad_pcb]
2025-03-31 change edgecuts dimensions
    change to edgecuts in pcb and changes to schematic
    [RP2350_80QFN_minimal.kicad_pcb, RP2350_80QFN_minimal.kicad_sch]
2025-03-31 change pcb edgecuts and add comments
    [RP2350_80QFN_minimal.kicad_pcb]
2025-04-09 Replaced project with RP2350A variant
    Replaced the RP2350B reference project files with RP2350A reference files
    [RP2350_60QFN_minimal.kicad_pcb, RP2350_60QFN_minimal.kicad_sch, RP2350_80QFN_minimal.kicad_pcb, RP2350_80QFN_minimal.kicad_sch, RP2350_80QFN_minimal.sch, RP2350_QFN60.step, RP2350_QFN80.step, untitled.kicad_sch]
2025-04-09 USB-C schematic
    replaced micro usb schematic with usb 2.0 type c plus 5.1k resistors on CC1/2
    [RP2350_60QFN_minimal.kicad_sch]
2025-04-09 Update PCB
    added usbc receptacle and resistor footprints to pcb
    [RP2350_60QFN_minimal.kicad_pcb, RP2350_60QFN_minimal.kicad_sch]
2025-04-09 Schematic text
    [RP2350_60QFN_minimal.kicad_pcb, RP2350_60QFN_minimal.kicad_sch]
2025-04-16 Update .gitignore
    added kicad #auto_saved_files# to gitignore
2025-04-16 Added secondary memory to schematic
    [RP2350_60QFN_minimal.kicad_sch, untitled.kicad_sch]
2025-04-24 Added minimal RP2350B reference project
    [RP2350_60QFN_minimal.kicad_pcb, RP2350_60QFN_minimal.kicad_sch, RP2350_80QFN_minimal.kicad_pcb, RP2350_80QFN_minimal.kicad_sch, RP2350_80QFN_minimal.sch, RP2350_QFN60.step, RP2350_QFN80.step, untitled.kicad_sch]
2025-04-24 first save
    [RP2350_80QFN_minimal.kicad_sch]
2025-04-24 Imported RP2350A symbol
    [RP2350_80QFN_minimal.kicad_pcb]
2025-04-24 Imported RP2350A footprint and symbols
    [RP2350_QFN60.step]
2025-04-24 Added circuit schematic for debugprobe
    [RP2350_80QFN_minimal.kicad_sch, untitled.kicad_sch]
2025-04-24 Added hex displays schematic sheet
    [RP2350_80QFN_minimal.kicad_sch, debugprobe.kicad_sch, hexdisplays.kicad_sch]
2025-04-25 added schematic page
    [RP2350_80QFN_minimal.kicad_sch, buttons.kicad_sch]
2025-04-25 Created a sheet for LEDs
    [RP2350_80QFN_minimal.kicad_sch, debugprobe.kicad_sch, leds.kicad_sch]
2025-04-25 added led symbol
    [leds.kicad_sch]
2025-04-25 added hierarchical label to root
    [leds.kicad_sch]
2025-04-25 added leds schematic page
    [RP2350_80QFN_minimal.kicad_sch, debugprobe.kicad_sch, hexdisplays.kicad_sch, leds.kicad_sch]
2025-04-25 Placed hierarchical labels in debugprobe
    [RP2350_80QFN_minimal.kicad_sch, debugprobe.kicad_sch, leds.kicad_sch]
2025-04-25 Added debugger labels to root
    moved some symbols around
    [RP2350_80QFN_minimal.kicad_sch, debugprobe.kicad_sch]
2025-04-28 Assigned footprints to symbols
    [debugprobe.kicad_sch, leds.kicad_sch]
2025-04-28 Added debugprobe components to pcb
    added pinheader connector to debug probe
    [RP2350_80QFN_minimal.kicad_pcb, RP2350_80QFN_minimal.kicad_sch, debugprobe.kicad_sch, untitled.kicad_sch]
2025-04-28 Created HT16K33-28SOP symbol
    assigned new symbol footprint the pre-defined footprint for SOP-28 package
    [RP2350_80QFN_minimal.kicad_pcb, hexdisplays.kicad_sch]
2025-04-29 Update hex displays
    Added 7-segment display symbol, labels, i2c pull-up resistors, capacitor.
    Synced added components to pcb.
    [RP2350_80QFN_minimal.kicad_pcb, RP2350_80QFN_minimal.kicad_sch, hexdisplays.kicad_sch]
2025-04-29 Updated pcb
    [RP2350_80QFN_minimal.kicad_pcb]
2025-04-29 Update to pcb
    [RP2350_80QFN_minimal.kicad_pcb]
2025-04-29 Update to PCB
    Added debug UART trace to main microcontroller
    [RP2350_80QFN_minimal.kicad_pcb]
2025-05-01 LED Sheet , Two Buttons
    Attempt at completing LED sheet with resistors and GPIO connections.
    Also two buttons in the Button sheet.
    [RP2350_80QFN_minimal.kicad_sch, buttons.kicad_sch, leds.kicad_sch]
2025-05-02 Update RP2350_80QFN_minimal.kicad_pcb
    Changed edge cut dimensions to 10mmX10mm
    [RP2350_80QFN_minimal.kicad_pcb]
2025-05-02 Small update to pcb
    [RP2350_80QFN_minimal.kicad_pcb]
2025-05-02 Update leds.kicad_sch
    added 74hc595 soic symbol
    [leds.kicad_sch]
2025-05-02 Update RP2350_80QFN_minimal.kicad_pcb
    Added vbus trace to lower board
    [RP2350_80QFN_minimal.kicad_pcb]
2025-05-02 Update RP2350_80QFN_minimal.kicad_pcb
    changed debugger uart trace to 0.25 mm
    [RP2350_80QFN_minimal.kicad_pcb]
2025-05-02 Updated leds schematic
    Added 74HC595, leds and resistors
    [RP2350_80QFN_minimal.kicad_pcb, leds.kicad_sch]
2025-05-02 Connected GPIOs to Shift Register pins
    [RP2350_80QFN_minimal.kicad_sch, leds.kicad_sch]
2025-05-02 Update RP2350_80QFN_minimal.kicad_sch
    added some description text
    [RP2350_80QFN_minimal.kicad_sch]
2025-05-02 Update leds.kicad_sch
    Added description text
    [leds.kicad_sch]
2025-05-02 Update hexdisplays.kicad_sch
    added NCP1117-5.0 linear voltage regulator symbol
    [hexdisplays.kicad_sch]
2025-05-02 Update hexdisplays.kicad_sch
    Created symbol for a HT16K33A-24SSOP ic with existing SSOP-24 footprint
    [hexdisplays.kicad_sch]
2025-05-04 Swith buttons added 22*11mm
    Button_Switch_SMD:SW_DIP_SPSTx08_Slide_Omron_A6S-810x_W8.9mm_P2.54mm
    [buttons.kicad_sch]
2025-05-05 Update to schematic and pcb
    Changed ht16k33 package from 28SOP to 24SSOP
    Placed pcb footprints
    [RP2350_80QFN_minimal.kicad_pcb, RP2350_80QFN_minimal.kicad_sch, debugprobe.kicad_sch, hexdisplays.kicad_sch, leds.kicad_sch]
2025-05-05 Update RP2350_80QFN_minimal.kicad_pcb
    Connected led and shift register wires
    [RP2350_80QFN_minimal.kicad_pcb]
2025-05-05 wires to hex display
    [RP2350_80QFN_minimal.kicad_pcb]
2025-05-05 Update RP2350_80QFN_minimal.kicad_pcb
    Connected wires to switch and buttons
    [RP2350_80QFN_minimal.kicad_pcb]
2025-05-06 VBUS to VDD connection
    [RP2350_80QFN_minimal.kicad_pcb, RP2350_80QFN_minimal.kicad_sch]
2025-05-06 Update
    fixed some errors in electrical rules checker
    [RP2350_80QFN_minimal.kicad_pcb, RP2350_80QFN_minimal.kicad_sch, debugprobe.kicad_sch]
2025-05-06 small update
    [RP2350_80QFN_minimal.kicad_pcb, RP2350_80QFN_minimal.kicad_sch]
2025-05-06 Remove mounting holes
    [RP2350_80QFN_minimal.kicad_pcb, RP2350_80QFN_minimal.kicad_sch]
2025-05-06 Update RP2350_80QFN_minimal.kicad_pcb
    added silkscreen text
    [RP2350_80QFN_minimal.kicad_pcb]
2025-05-07 Increase width of some traces
    [RP2350_80QFN_minimal.kicad_pcb]
2025-05-08 Update RP2350_80QFN_minimal.kicad_pcb
    Small copper fill fix
    [RP2350_80QFN_minimal.kicad_pcb]
2025-05-09 Update RP2350_80QFN_minimal.kicad_pcb
    moved hex display outside of 5mm of pcb edge
    [RP2350_80QFN_minimal.kicad_pcb]
2025-05-09 Update RP2350_80QFN_minimal.kicad_pcb
    Fixed some DRC errors
    [RP2350_80QFN_minimal.kicad_pcb]
2025-05-12 Update pushbutton footprints on pcb
    Changed from omron pushbutton footprints to custom footprints for JLCPCB part
    [RP2350_80QFN_minimal.kicad_pcb, buttons.kicad_sch]
2025-05-13 Update schematic
    added schottky diode to vbus on microcontroller and debug probe
    [RP2350_80QFN_minimal.kicad_sch, debugprobe.kicad_sch]
2025-05-13 Update to schematic and pcb
    Changed:
    - Added 100n decoupling capacitors to both 74HC595
    - Changed ground plane to single common ground plane
    - Added schottky diode to usb vbus inputs, creating separate vbus and vsys
    [RP2350_80QFN_minimal.kicad_pcb, RP2350_80QFN_minimal.kicad_sch, accelerometer.kicad_sch, debugprobe.kicad_sch, leds.kicad_sch]
2025-05-13 Added LIS2DW12TR component
    - added LIS2DW12TR symbol and footprint
    - added circuit schematic for LIS2DW12TR
    [LIS2DW12TR.step, accelerometer.kicad_sch]
2025-05-13 Update accelerometer
    Added accelerometer circuit to PCB editor
    [RP2350_80QFN_minimal.kicad_pcb, RP2350_80QFN_minimal.kicad_sch, hexdisplays.kicad_sch, leds.kicad_sch]
2025-05-14 Red, Yellow, Emerald plus resistors, to GPIOs
    [RP2350_80QFN_minimal.kicad_sch]
2025-05-14 Update PCB
    Created footprint for SW_SPDT symbol
    Added switch footprint to PCB and connected VSYS
    [RP2350_80QFN_minimal.kicad_pcb, RP2350_80QFN_minimal.kicad_sch, debugprobe.kicad_sch]
2025-05-14 Changed Resistor numbers
    [RP2350_80QFN_minimal.kicad_sch]
2025-05-14 8 more LEDs + 3rd Shift register
    [leds.kicad_sch]
2025-05-14 Big update
    [RP2350_80QFN_minimal.kicad_pcb, RP2350_80QFN_minimal.kicad_sch, buttons.kicad_sch, debugprobe.kicad_sch, hexdisplays.kicad_sch, leds.kicad_sch]
2025-05-15 Fabrication toolkit production
    Created production folder from fabrication toolkit
    [RP2350_80QFN_minimal.kicad_pcb]
2025-05-15 Added capacitor to LED driver power input
    [RP2350_80QFN_minimal.kicad_pcb, hexdisplays.kicad_sch]
2025-05-15 Changed edgecuts to within 100mmX100mm
    [RP2350_80QFN_minimal-B_Cu.gbr, RP2350_80QFN_minimal-B_Mask.gbr, RP2350_80QFN_minimal-B_Paste.gbr, RP2350_80QFN_minimal-B_Silkscreen.gbr, RP2350_80QFN_minimal-Edge_Cuts.gbr, RP2350_80QFN_minimal-F_Cu.gbr, RP2350_80QFN_minimal-F_Mask.gbr, RP2350_80QFN_minimal-F_Paste.gbr]
2025-05-15 Datasheet och länk till JLCPCP för resistorna
    [leds.kicad_sch]
2025-05-15 gerber files update
    [RP2350_80QFN_minimal-B_Cu.gbr, RP2350_80QFN_minimal-B_Mask.gbr, RP2350_80QFN_minimal-B_Paste.gbr, RP2350_80QFN_minimal-B_Silkscreen.gbr, RP2350_80QFN_minimal-Edge_Cuts.gbr, RP2350_80QFN_minimal-F_Cu.gbr, RP2350_80QFN_minimal-F_Mask.gbr, RP2350_80QFN_minimal-F_Paste.gbr]
2025-05-15 Update 8-bit switch, footprint, datasheet
    [RP2350_80QFN_minimal.kicad_pcb, buttons.kicad_sch, leds.kicad_sch]
2025-05-16 PNG and LCSC numbers
    [RP2350_80QFN_minimal-B_Cu.gbr, RP2350_80QFN_minimal-B_Mask.gbr, RP2350_80QFN_minimal-B_Paste.gbr, RP2350_80QFN_minimal-B_Silkscreen.gbr, RP2350_80QFN_minimal-Edge_Cuts.gbr, RP2350_80QFN_minimal-F_Cu.gbr, RP2350_80QFN_minimal-F_Mask.gbr, RP2350_80QFN_minimal-F_Paste.gbr]
2025-05-16 removed production and gerbers
    [RP2350_80QFN_minimal-B_Cu.gbr, RP2350_80QFN_minimal-B_Mask.gbr, RP2350_80QFN_minimal-B_Paste.gbr, RP2350_80QFN_minimal-B_Silkscreen.gbr, RP2350_80QFN_minimal-Edge_Cuts.gbr, RP2350_80QFN_minimal-F_Cu.gbr, RP2350_80QFN_minimal-F_Mask.gbr, RP2350_80QFN_minimal-F_Paste.gbr]
2025-05-16 Revert "Merge branch 'main' of https://github.com/alvestav/alvestav-lee-thesis-project-2025"
    This reverts commit 492c910224f218c530b72a86f026f374fdb1ba99, reversing
    changes made to 8b8c3067a07da89d4cec6960bc27222e60866367.
    [accelerometer.kicad_sch, buttons.kicad_sch, debugprobe.kicad_sch, hexdisplays.kicad_sch]
2025-05-16 Added LCSC numbers to parts
    [RP2350_80QFN_minimal.kicad_sch, accelerometer.kicad_sch, buttons.kicad_sch, debugprobe.kicad_sch, hexdisplays.kicad_sch, leds.kicad_sch]
2025-05-16 Added Emerald LED LCSC number
    [RP2350_80QFN_minimal.kicad_sch, debugprobe.kicad_sch, leds.kicad_sch]
2025-05-16 Fixed overlapping silkscreen
    [RP2350_80QFN_minimal.kicad_pcb]
2025-05-16 Updated PCB LSCS values
    [RP2350_80QFN_minimal.kicad_pcb, RP2350_80QFN_minimal.kicad_sch, accelerometer.kicad_sch, buttons.kicad_sch, debugprobe.kicad_sch, hexdisplays.kicad_sch, leds.kicad_sch]
2025-05-16 New Flash memory footprint
    footprint from snapmagic
    [RP2350_80QFN_minimal.kicad_pcb, RP2350_80QFN_minimal.kicad_sch, W25Q128JVSIQ.step, accelerometer.kicad_sch, debugprobe.kicad_sch]
2025-05-16 Added MMA8451QR1 symbol and footprint
    MMA8451QR1 Accelerometer
    [MMA8451QR1.step, RP2350_80QFN_minimal.kicad_pcb, accelerometer.kicad_sch]
2025-05-16 New accelerometer schematic
    MMA8451QR1
    [RP2350_80QFN_minimal.kicad_sch, accelerometer.kicad_sch, leds.kicad_sch]
2025-05-16 Accelerometer footprint added
    [RP2350_80QFN_minimal.kicad_sch, accelerometer.kicad_sch]
2025-05-18 Added GS3011CR-G symbol and footprint
    GS3011CR-G SMD 7-segment display from jlcpcb
    [hexdisplays.kicad_sch]
2025-05-18 Testing electrical rules
    [RP2350_80QFN_minimal.kicad_sch, accelerometer.kicad_sch, buttons.kicad_sch, debugprobe.kicad_sch, hexdisplays.kicad_sch, leds.kicad_sch]
2025-05-19 Update pcb
    [RP2350_80QFN_minimal.kicad_pcb, RP2350_80QFN_minimal.kicad_sch, debugprobe.kicad_sch]
2025-05-19 Update GS3011CR-G footprint
    [RP2350_80QFN_minimal.kicad_pcb, RP2350_80QFN_minimal.kicad_sch, accelerometer.kicad_sch, buttons.kicad_sch, debugprobe.kicad_sch, hexdisplays.kicad_sch, leds.kicad_sch]
2025-05-19 Update GS3011CR-G.kicad_mod
    added link to datasheed
2025-05-19 Added Accelerometer datasheet and link to JLCPCB
    [accelerometer.kicad_sch]
2025-05-19 Update hex display pcb traces
    [RP2350_80QFN_minimal.kicad_pcb, RP2350_80QFN_minimal.kicad_sch, debugprobe.kicad_sch, hexdisplays.kicad_sch, leds.kicad_sch]
2025-05-20 Update usb power switch
    [RP2350_80QFN_minimal.kicad_pcb, RP2350_80QFN_minimal.kicad_sch, debugprobe.kicad_sch, hexdisplays.kicad_sch]
2025-05-20 Update RP2350_80QFN_minimal.kicad_pcb
    moved switch 1 mm
    [RP2350_80QFN_minimal.kicad_pcb]
2025-05-20 Update accelerometer
    Pulled SA0 pin to ground for slave address 0011100 (0x1C)
    [RP2350_80QFN_minimal.kicad_pcb, RP2350_80QFN_minimal.kicad_sch]
2025-05-20 Added LCSC number to accelerometer
    [accelerometer.kicad_sch]
2025-05-20 Production files
    [RP2350_80QFN_minimal.kicad_pcb, debugprobe.kicad_sch, hexdisplays.kicad_sch]
2025-05-20 Update production files
    [RP2350_80QFN_minimal.kicad_pcb]
2025-05-20 Update csv files in gitignore and bom and positions cvs files
    [bom.csv, designators.csv, positions.csv]
2025-05-21 Created file for switch footprint
    [RP2350_80QFN_minimal.kicad_pcb, debugprobe.kicad_sch]
2025-05-21 Comment text
    [RP2350_80QFN_minimal.kicad_pcb]
2025-05-22 Exported Schematics as SVG
2025-05-22 Created Figures
    [accelerometer.kicad_sch, buttons.kicad_sch, hexdisplays.kicad_sch]
2025-06-02 Added test program
    Added test program based on ht16k33_i2c pico example
2025-08-15 Updated accelerometer sensitivity numbers
    Fixed g-force reading
    [ht16k33_i2c.c]
2025-08-15 Update ht16k33_i2c.c
    changed program to detect a difference in button status to trigger traffic light leds instead of directly lighting leds based on status of buttons
